choikiha7440-ops/bodycam-project/바디캠_프로젝트_학습서_2026-10-01.docx

바디캠 프로젝트 학습서 (2026-10-01)

ESP32-S3 보드로 만든 첫 진짜 바디캠: 카메라, SD카드, 서버 업로드, 그리고 디버깅 기록

저장소: https://github.com/choikiha7440-ops/bodycam-project

# 목차

1. 오늘의 결과 요약

2. 하드웨어 준비

3. 개발 환경 설정

4. 단계별 시험

5. 펌웨어 버전별 기록

6. 서버 버전별 기록

7. 문제 해결 기록

8. 서버 업데이트 절차

9. 오늘의 교훈

10. 아직 확인하지 못한 것과 다음 할 일

11. 복습 퀴즈

# 1. 오늘의 결과 요약

## 1.1 된 것

항목 | 확인 방법
XIAO ESP32S3 Sense 첫 업로드 | 점검 코드로 칩, PSRAM 8MB, SD 31.9GB, SD 쓰기와 읽기
OV3660 카메라 실시간 영상 | 카메라 예제로 브라우저에서 UXGA(1600x1200) 영상 확인
바디캠 펌웨어 실행 | 시리얼에 MQTT 연결됨, 시간 동기화 완료
라떼판다 BODYCAM 핫스팟 접속 | 와이파이 연결 10.42.0.82
대시보드에 진짜 바디캠 표시 | cam01 카드에 REC 시간과 라이브 영상
rec 명령으로 사전녹화 업로드 시작 | 시리얼 서버 업로드 시작, [ws] 연결됨
영상 항목 전송 | 보낸 항목 640개 (32초 x 초당 20개와 일치)

## 1.2 안 된 것 또는 확인하지 못한 것

항목 | 상태
녹화를 끝낸 뒤 서버의 확인 응답을 보드가 받는 것 | 되지 않음. [ws] 수신: 줄이 한 번도 나오지 않음
위 문제를 서버 1.3이 해결하는지 | 개발 PC에서만 시험함. 라떼판다에 아직 적용하지 못함
보드가 스스로 재시작된 원인 | 모름
MP4 안의 사전녹화 10초, 소리, 화면 방향 | 아직 재생해 보지 못함

솔직하게 적어 둔다. "된 것"은 눈으로 확인한 것만 넣었다.

# 2. 하드웨어 준비

## 2.1 구성품 (XIAO ESP32S3 Sense)

부품 | 설명
XIAO 본체 | USB-C, ESP32-S3 칩
확장 보드(Sense) | 카메라 커넥터, 마이크, microSD 슬롯(뒷면)
OV3660 카메라 | 주황색 필름 케이블에 이름이 적혀 있음
안테나 | 본체의 작은 금색 동그라미(U.FL)에 수직으로 눌러 끼움
방열판 | 본체 뒷면에 붙임
핀 헤더 | 납땜해서 버튼, LED를 연결할 때 사용 (아직 안 씀)

- microSD 슬롯은 본체가 아니라 확장 보드 뒷면에 있다.
- 카메라 렌즈의 초록색 보호 필름을 떼어야 선명하다.

## 2.2 SD카드 포맷

카드 | 규격 | 처리
SanDisk Ultra 32GB | microSDHC | 윈도우에서 FAT32로 바로 포맷 (볼륨 레이블에 CAM01처럼 이름)
삼성 EVO 64GB | microSDXC (exFAT) | ESP32 라이브러리는 FAT32가 확실함. 윈도우 기본 포맷에는 FAT32 선택지가 없어 별도 프로그램이 필요. 예비용

- 포맷 후 안전하게 제거하고 카드를 슬롯에 딸깍 소리가 나게 넣는다.
- 새 카드 포맷 직후 윈도우 저장소 화면에는 128KB 사용으로 나오는데, 윈도우가 만든 관리 정보라 정상이다.

# 3. 개발 환경 설정

## 3.1 아두이노 IDE (Tools 메뉴)

항목 | 설정 | 이유
Board | XIAO_ESP32S3 | XIAO_ESP32S3_PLUS는 다른 제품
PSRAM | OPI PSRAM | 카메라와 링버퍼가 이 메모리를 씀
USB CDC On Boot | Enabled | 시리얼 모니터 출력
Partition Scheme | Default with spiffs (3MB APP/1.5MB SPIFFS) | 다른 보드의 "Huge APP"은 이 보드에 없음
Port | 보드를 꽂았을 때 새로 생기는 COM 번호

- 시리얼 모니터 속도는 115200 (코딩어레이 우노의 9600과 다름).
- 포트가 안 보이면 BOOT 버튼을 누른 채 USB를 꽂는다.
- 라이브러리: PubSubClient (Nick O'Leary), WebSockets (Markus Sattler). 검색할 때 철자 주의 (PubSubClint는 오타).

## 3.2 업로드 때 나오는 메시지

메시지 | 뜻
Hash of data verified, Hard resetting | 업로드 성공
Multiple libraries were found for "SD.h" | 에러가 아니라 안내. ESP32 기본 라이브러리를 쓴다는 뜻
Sketch must be verified before starting a debug session | 디버그 버튼(벌레 모양)을 눌렀을 때 나오는 안내. 업로드는 화살표 버튼

# 4. 단계별 시험

한 번에 모든 것을 올리지 않고 작은 단계로 나눠 확인했다.

## 4.1 1단계: 보드 점검 코드

Serial.printf("칩: %s, 코어 %d개\n", ESP.getChipModel(), ESP.getChipCores());

Serial.printf("PSRAM: %d KB\n", ESP.getPsramSize() / 1024);

SD.begin(21); // Sense 보드의 SD 칩 선택 핀

결과: ESP32-S3, 코어 2개, PSRAM 8192KB, SD 30436MB, SD 쓰기와 읽기 성공.

## 4.2 2단계: 카메라 웹서버 예제

- File, Examples, ESP32, Camera, CameraWebServer를 연다.
- board_config.h에서 #define CAMERA_MODEL_XIAO_ESP32S3 한 줄만 켠다.
- 와이파이 이름과 비밀번호를 입력한다. PC와 같은 와이파이여야 브라우저로 볼 수 있다.
- 시리얼에 나온 주소를 브라우저에 입력하고 Start Stream.

## 4.3 3단계: 발열 확인

- 최고 화질(UXGA)로 몇 분 틀어 두고 만졌을 때 약간 따뜻한 정도였다.
- 바디캠 설정은 VGA(640x480), 품질 12라서 이보다 부담이 적다.
- 아직 30분 이상 장시간 시험은 하지 않았다.

## 4.4 4단계: 바디캠 펌웨어

- 버튼이 없어서 시리얼 모니터에 rec을 입력하면 버튼을 누른 것처럼 동작하게 만들었다.
- rec 한 번은 녹화 시작, 한 번 더는 종료.
- info는 현재 상태를 보여준다.

# 5. 펌웨어 버전별 기록

버전 | 변경 | 계기
0.2.0 | 처음 작성 | 보드 도착 전 설계
0.2.1 | rec 명령, 파티션 안내 정정 | 버튼을 납땜하기 전에 시험하기 위해
0.2.2 | RecState를 config.h로 이동 | 컴파일 에러 'RecState' does not name a type
0.2.3 | 업로드 포기 이유, 신호, 보낸 항목 수 출력 | 왜 업로드가 반복 실패하는지 알 수 없었음
0.2.4 | 확인 응답을 연결 상태보다 먼저 확인, 받은 글자 출력 | 코드에서 순서 허점을 발견
0.2.5 | 재시작 이유, SD 재시도, 힙 메모리 출력 | 스스로 재시작되고 SD를 못 찾음

## 5.1 컴파일 에러 `'RecState' does not name a type`

- 증상: getRec(), startLive(), publishEvent() 세 곳에서 같은 에러.
- 원인: 아두이노 IDE는 컴파일 전에 모든 함수의 선언(프로토타입)을 파일 맨 위에 자동으로 만들어 넣는다. RecState를 반환하거나 받는 함수의 선언이 구조체 정의보다 먼저 나와서 형식을 모른다.
- 해결: 직접 만든 구조체는 .ino가 아니라 헤더(config.h)에 정의한다.

## 5.2 `cam_hal: FB-OVF` 경고

- 카메라 프레임 버퍼가 넘친다는 경고. 영상이 정상적으로 찍히고 업로드되어서 무시해도 된다.
- 로그 수준을 낮춰서 숨기려 했지만 효과가 없었다. 카메라 드라이버가 직접 출력하기 때문이다.

# 6. 서버 버전별 기록

버전 | 변경 | 확인용 검색어
1.0 | 처음 버전 (9/29)
1.1 | 중복 연결로 생기던 에러 수정, 상태 정리 보장, 복구 장치 | refresh_uploading
1.2 | 영상이 없는 접속은 녹화 중으로 표시하지 않음 (유령 방지) | announced
1.3 | end 응답 뒤 보드가 닫을 때까지 최대 3초 대기 | wait_for(ws.receive()

## 6.1 서버 1.1: 대시보드가 빨간색에 갇히던 버그

File ".../app/main.py", line 208, in flush

FileNotFoundError: ... /raw/cam01_20261001-111515-a003/meta.json

단계 | 일어난 일
1 | 와이파이가 흔들려 보드가 같은 녹화에 다시 접속했다. 이전 연결도 서버에 남아 있었다.
2 | 한 연결이 end로 정상 종료되자 서버가 MP4를 만들고 임시 폴더를 지웠다.
3 | 남아 있던 다른 연결이 닫히면서 지워진 폴더에 쓰다가 에러가 났다.
4 | 에러가 "상태 정리" 코드보다 앞에서 났기 때문에 uploading과 recording이 true로 남았다.

교훈: 정리 코드는 finally에 넣고, 정리 도중 에러가 나도 다음 정리가 실행되게 감싼다.

## 6.2 서버 1.2: 유령 녹화

- 서버가 보드의 웹소켓 재접속을 새 녹화로 착각해 REC 0:04와 검은 화면을 띄웠다.
- 접속 순간이 아니라 첫 영상 프레임이 들어온 순간부터 녹화 중으로 표시하도록 바꿨다.

## 6.3 서버 1.3: 확인 응답을 놓치는 문제 (추정)

- 서버는 end를 받으면 {"ok": true}를 보내고 곧바로 연결을 닫는다.
- 보드의 웹소켓 라이브러리가 연결 종료를 먼저 알아채고 아직 읽지 않은 응답을 버릴 수 있다고 추정했다.
- 근거: 보드에 [ws] 수신: 줄이 한 번도 안 나왔고, 개발 PC의 파이썬 클라이언트는 응답을 받았다.
- 대응: 서버가 응답 뒤 보드가 먼저 닫을 때까지 최대 3초 기다린다.
- 추정이다. 실제 보드로 확인하지 못했다. 틀렸다면 서버 로그로 다시 원인을 찾는다.

# 7. 문제 해결 기록

증상 | 원인 | 해결
라이브러리 검색에 안 나옴 | 검색어 오타 (PubSubClint) | PubSubClient
컴파일 에러 RecState | 아두이노가 함수 선언을 자동으로 앞에 넣음 | 구조체를 config.h로 이동
대시보드에 바디캠이 안 뜸. 휴대폰도 BODYCAM에 접속 안 됨 | 라떼판다 핫스팟(USB 와이파이 동글)이 멈춤 | nmcli con down bodycam-ap 후 up. 이후 보드가 접속
녹화를 끝냈는데 대시보드가 계속 빨강 | 서버 버그 (6.1) | 서버 1.1
업로드가 계속 중단되고 재전송이 반복 | 확인 응답을 놓침 (추정) | 서버 1.3 (미확인)
서버를 업데이트했는데 효과가 없음 | 다운로드 폴더의 예전 zip을 보냄 | 아래 7.1
보드 재시작 뒤 SD카드 없음 또는 인식 실패 | 재시작 때 카드가 중간 상태에 갇힘 | USB를 뽑고 10초 뒤 다시 연결. 카드는 망가지지 않음
명령어를 윈도우에서 입력했더니 systemctl 용어가 인식되지 않음 | 라떼판다 명령을 PowerShell에 입력 | 프롬프트로 구분 (아래 7.2)

## 7.1 잘못된 파일을 보낸 일

- 단서: 압축을 풀 때 __pycache__/sd2mp4.cpython-312.pyc가 나왔다. 새 zip에는 없는 파일이었다.
- 확인 방법: 설치 후 grep -c "refresh_uploading" 결과가 0이었다.
- 예방: 풀기 전에 unzip -p 파일.zip bodycam-server/app/main.py | grep -c 검색어로 내용을 먼저 본다.
- 파일 이름이나 크기를 눈으로 읽는 것보다, 내용 안의 고유한 검색어가 정확하다.

## 7.2 어느 화면에서 입력하나

프롬프트 | 위치 | 쓰는 명령
PS C:\Users\CKH\Downloads> | 윈도우 PowerShell | scp, ssh, dir
panda@lattepanda:~$ | 라떼판다 | systemctl, unzip, grep, journalctl

# 8. 서버 업데이트 절차

순서 | 위치 | 명령
1 | 윈도우 | 예전 bodycam-server*.zip을 지우고 새로 다운로드
2 | 윈도우 | scp bodycam-server.zip panda@lattepanda:~
3 | 윈도우 | ssh panda@lattepanda
4 | 라떼판다 | 풀기 전에 새 파일인지 확인 (아래 명령, 결과 1이면 새 파일)
5 | 라떼판다 | cd ~ (띄어쓰기 필요)
6 | 라떼판다 | unzip -o bodycam-server.zip
7 | 라떼판다 | sudo systemctl restart bodycam
8 | 라떼판다 | systemctl is-active bodycam (active)
9 | 라떼판다 | grep -c "wait_for(ws.receive()" ~/bodycam-server/app/main.py (1)

4번 명령:

unzip -p ~/bodycam-server.zip bodycam-server/app/main.py | grep -c "wait_for(ws.receive()"

- 녹화본(recordings/)과 바디캠 이름(data/)은 덮어써지지 않는다.
- 이미 설치된 서버를 업데이트할 때는 install.sh가 필요 없다.
- 펌웨어는 라떼판다로 보내지 않는다. 윈도우 PC의 아두이노 IDE로 USB 업로드한다.

# 9. 오늘의 교훈

- 추측하기 전에 측정한다. "신호가 약해서 끊긴다"는 가설은 신호 세기를 출력해 보니 틀렸다(-52 dBm으로 아주 좋음). 진단 출력(0.2.3)이 방향을 바꿨다.
- 화면에 보이는 성공이 진짜 성공이 아닐 수 있다. 대시보드가 초록으로 돌아온 것은 MQTT 이벤트만으로도 가능해서, 영상이 올라갔다는 증거가 아니었다. 증거는 MP4 파일과 서버 로그다.
- 한 번에 하나만 바꾼다. 여러 개를 바꾸면 무엇이 효과였는지 알 수 없다.
- 파일은 내용으로 확인한다. 이름이나 날짜가 아니라 고유한 검색어로 확인한다.
- 정리 코드는 반드시 실행되게 한다. finally 안에서도 에러가 날 수 있으니 한 번 더 감싼다.
- 서버와 클라이언트는 한쪽이 먼저 닫으면 마지막 메시지를 잃을 수 있다. 마지막 메시지를 받았음을 확인한 쪽이 닫는 편이 안전하다.
- 보드 설정은 보드마다 다르다. 다른 보드의 안내를 그대로 따르지 않고 실제 메뉴에서 확인한다.

# 10. 아직 확인하지 못한 것과 다음 할 일

## 10.1 아직 모르는 것

- 서버 1.3이 확인 응답 문제를 해결하는지
- 보드가 스스로 재시작된 원인 (패닉인지, 전원 문제인지)
- MP4 안에 사전녹화 10초, 소리, 올바른 화면 방향이 들어 있는지
- 업로드를 여러 번 반복해도 메모리(힙)가 줄지 않는지

## 10.2 다음에 할 일

- 라떼판다에 서버 1.3 적용 (7.1의 방법으로 파일 내용부터 확인)
- 펌웨어 0.2.5 업로드, 시리얼의 [재시작 이유]와 SD 줄 확인
- rec 후 시리얼에 [ws] 수신: {"ok": true ...}와 업로드 완료가 나오는지 확인
- 녹화 기록의 MP4를 재생해서 사전녹화, 소리, 방향 확인
- 같은 시험을 3번 반복해서 결과 표로 기록
- 안테나를 다시 끼우고 신호 세기 비교
- 나머지 보드 2대에 같은 펌웨어, id cam02, id cam03
- 버튼, RGB LED, 배터리 분압 회로 납땜
- MediaTek 와이파이 동글 교체 검토

# 11. 복습 퀴즈

- 1. XIAO ESP32S3 Sense의 microSD 슬롯은 어디에 있는가?
- 2. 이 보드에서 PSRAM 설정은 무엇으로 해야 하는가?
- 3. 시리얼 모니터 속도는 우노와 어떻게 다른가?
- 4. 아두이노 IDE에서 직접 만든 구조체를 .ino에 두면 왜 에러가 나는가?
- 5. 대시보드가 초록색으로 돌아왔다는 것이 업로드 성공의 증거가 못 되는 이유는?
- 6. 풀기 전에 zip 안의 파일이 최신인지 확인하는 방법은?
- 7. 보드 로그의 보낸 항목 640개는 왜 이 녹화에서 "영상을 다 보냈다"는 근거가 되는가?
- 8. 서버가 end 응답 직후 연결을 닫으면 어떤 일이 생길 수 있다고 추정했는가?
- 9. SD카드가 재시작 뒤에 안 읽혔을 때 가장 먼저 할 일은?

## 정답

- 1. 확장 보드(Sense) 뒷면
- 2. OPI PSRAM
- 3. 115200 (우노는 9600)
- 4. 아두이노가 컴파일 전에 함수 선언을 파일 맨 위에 자동으로 넣는데, 그 선언이 구조체 정의보다 앞에 나오기 때문. 구조체를 헤더에 두면 해결된다.
- 5. 대시보드의 빨강과 초록은 MQTT의 rec_start와 rec_stop 신호로도 바뀌기 때문. 영상이 올라갔는지는 MP4와 서버 로그로 확인해야 한다.
- 6. unzip -p 파일.zip 경로 | grep -c 고유한검색어
- 7. 10초 사전녹화 + 약 22초 녹화 = 32초이고, 초당 영상 10개 + 음성 10개로 32 x 20 = 640이기 때문
- 8. 보드의 웹소켓 라이브러리가 응답을 읽기 전에 연결 종료를 알아채서 응답을 놓칠 수 있다 (추정)
- 9. USB를 뽑고 10초 뒤 다시 연결해서 카드까지 전원을 완전히 끊었다 켠다
