choikiha7440-ops/bodycam-project/bodycam-project/bodycam project 10월 2일 최종버전/CHANGELOG.md

# 버전별 기록 (CHANGELOG)

"확인" 표시의 뜻
- **보드 확인**: 실제 XIAO ESP32S3 Sense 보드와 라떼판다에서 동작을 확인함
- **PC 시험**: 개발 PC에서 가짜 바디캠(파이썬)으로 시험함. 실제 보드로는 아직 확인 안 됨
- **문법 검사만**: 컴파일과 동작은 아직 확인 안 됨

---

## 펌웨어 (bodycam_firmware)

| 버전 | 날짜 | 변경 | 상태 |
|---|---|---|---|
| 0.2.0 | 2026-09-28 | 처음 작성. 링버퍼 사전녹화, SD 블랙박스, 서버 업로드, LED, 배터리 | 문법 검사만. 아두이노 IDE에서는 `RecState` 컴파일 에러가 남 |
| 0.2.1 | 2026-10-01 | 시리얼 `rec` 명령 추가 (버튼 없이 녹화 시험). 파티션 안내를 기본값(Default with spiffs)으로 정정 | `RecState` 컴파일 에러가 그대로 있음. 직접 고쳐서 보드 확인 |
| 0.2.2 | 2026-10-01 | `RecState` 구조체를 `config.h`로 이동 (아두이노가 함수 선언을 자동으로 앞에 넣기 때문) | 컴파일 통과. 같은 구조로 보드 확인 |
| 0.2.3 | 2026-10-01 | 업로드 포기 이유, 보낸 항목 수, 신호 세기, 웹소켓 연결 기록 출력. `info`에 rssi | 보드 확인. `FB-OVF` 경고 숨기기는 **효과 없음** |
| 0.2.4 | 2026-10-01 | 확인 응답(ack)을 연결 상태보다 먼저 확인. ack를 받으면 바로 연결 닫기. 받은 글자 출력 | 보드 확인(업로드, 동작). 서버 1.3과 함께 ack 수신은 미확인 (cam01이 아직 0.2.4) |
| 0.2.5 | 2026-10-01 | 재시작 이유 출력, SD 초기화 재시도(10MHz→4MHz), 힙 메모리 출력 | **보드 확인 (2026-10-02)**: cam01(COM7), cam02(COM8), cam03(COM9)에 업로드. 재시작 이유 출력, SD 10MHz 연결, 서버 1.3과 함께 ack 수신·업로드 완료 확인 |

### 펌웨어 보드 설정 (XIAO_ESP32S3)
- Board: XIAO_ESP32S3 / PSRAM: **OPI PSRAM** / USB CDC On Boot: **Enabled**
- Partition Scheme: **Default with spiffs (3MB APP/1.5MB SPIFFS)** (기본값, 다른 보드의 "Huge APP"과 다름)
- 라이브러리: PubSubClient (Nick O'Leary), WebSockets (Markus Sattler)

---

## 서버 (bodycam-server)

서버 코드 안에는 버전 번호가 없어서, 아래 "확인용 검색어"로 어떤 버전인지 알 수 있다.

| 버전 | 날짜 | 변경 | 확인용 검색어 | 상태 |
|---|---|---|---|---|
| 1.0 | 2026-09-29 | MQTT 수신, 웹소켓 업로드, 링 버퍼, MP4 변환, 대시보드 | (없음) | 시뮬레이터로 시험 |
| 1.1 | 2026-10-01 | 같은 녹화에 연결이 둘 붙었을 때 임시 폴더가 지워진 뒤 쓰다가 생기던 `FileNotFoundError` 수정. 연결 수 계산. 연결이 닫힐 때 상태 정리를 반드시 실행. 바디캠이 "대기 중"이라고 보고하면 녹화 표시 해제. 감시 루프가 "연결 없는데 업로드 중" 상태를 복구 | `refresh_uploading` | PC 시험. 라떼판다에 설치됨(검색어 3개 확인) |
| 1.2 | 2026-10-01 | 접속만 하고 영상이 없는 연결(유령)은 녹화 중으로 표시하지 않음. 첫 프레임이 들어온 순간부터 표시 | `announced` | PC 시험. 라떼판다 설치 여부는 확인 안 됨 |
| 1.3 | 2026-10-01 | `end` 확인 응답을 보낸 뒤 바디캠이 먼저 연결을 닫을 때까지 최대 3초 기다림 (응답을 읽기 전에 연결이 닫혀 응답을 놓치는 문제 대응) | `wait_for(ws.receive()` | **보드 확인 (2026-10-02)**: 라떼판다에 적용. 펌웨어 0.2.5에서 `[ws] 수신: {"ok": true ...}` 확인 |
| 1.4 | 2026-10-02 | 바디캠이 시간 동기화 전에 녹화하면 1970-01-01로 저장되던 문제 수정. 시각이 2020년 이전이면 서버 시계로 날짜를 다시 매김 (녹화 도중 동기화된 경우도 처리). MQTT `rec_start`의 시각도 같은 방식으로 보정 | `TIME_VALID_MS` | PC 시험 (동기화 전, 정상, 도중 동기화, 중복 프레임, 이벤트). **보드 확인 (2026-10-02)**: 라떼판다 적용(검색어 3). cam03을 부팅 직후 `rec` → 세션 `boot4197-0cb6`, 오늘 날짜 09:52:36으로 저장. 녹화 도중 동기화되는 경우는 보드로 미확인 |

### 서버 업데이트 절차 요약
1. 윈도우에서 `scp 파일 panda@lattepanda:~/bodycam-server.zip`
2. 라떼판다에서 **풀기 전에** 새 파일인지 확인: `unzip -p ~/bodycam-server.zip bodycam-server/app/main.py | grep -c "TIME_VALID_MS"` → 3 (1.4 기준)
3. `cd ~ && unzip -o bodycam-server.zip && sudo systemctl restart bodycam`
4. 설치 후 확인: `grep -c "TIME_VALID_MS" ~/bodycam-server/app/main.py` → 3 (1.4 기준)

---

## 해결된 것 (2026-10-02)

- **ack 문제**: 서버 1.3 + 펌웨어 0.2.5에서 `[ws] 수신:`과 `업로드 완료` 확인 (cam01, cam02, cam03 모두). cam01은 10:03:00 녹화, 세션 10:03:10보다 10초 앞에서 시작. 1.3과 0.2.5 중 어느 쪽이 결정적이었는지는 구분 안 됨.
- **시간 동기화 전 녹화 날짜**: 1.3까지는 1970-01-01로 저장됨. 서버 1.4로 해결 (cam03 09:52:36 녹화로 확인). 1.4 이전에 만든 1970-01-01 녹화는 그대로 남아 있음.
- **MP4 확인**: cam02 09:33:48 녹화. 세션 시작 09:33:58보다 10초 앞에서 시작(사전녹화 확인), 25초, 9fps, 소리 들림, 화면 방향 정상.

## 아직 해결되지 않은 것 (2026-10-02 기준)

1. **보드가 스스로 재시작된 원인**: `rst:0x3 (RTC_SW_SYS_RST)`가 한 번 관찰됨. 원인 미확인. 펌웨어 0.2.5의 `[재시작 이유]` 출력으로 확인 예정.
2. 재시작 직후 SD카드를 못 찾던 현상: USB 전원을 완전히 껐다 켜면 복구됨. 0.2.5의 재시도로 완화 예정(미확인).
3. 재시작 이유 `기타 (코드 11)`: 펌웨어 업로드 직후 cam01에서 나옴. ESP-IDF 기준 11은 USB에 의한 재시작(`ESP_RST_USB`)으로 업로드 후에는 정상으로 **추정**. 0.2.5의 이유 목록에 없어 "기타"로 표시됨. 다음 펌웨어에서 이름 추가 예정.
4. 라떼판다 USB 와이파이 동글(RTL8821CU)이 핫스팟을 오래 켜 두면 멈추는 일이 있음 (껐다 켜면 복구). MediaTek 동글 교체 예정.
