choikiha7440-ops/bodycam-project/bodycam-project/coding-array/mini_bodycam_v7/hangul.h

#pragma once
// 한글 글자 비트맵 (XBM 형식). Noto Sans CJK KR로 미리 그려서 넣은 그림입니다.
// 아두이노 우노는 메모리가 작아서 한글 글꼴 전체를 넣을 수 없어 필요한 글자만 그림으로 넣었어요.

const unsigned char K16_CHAL[] PROGMEM = { // 촬
  0x20, 0x08, 0x20, 0x08, 0xfe, 0x09, 0x30, 0x08, 0x58, 0x38, 0x8e, 0x09, 0x20, 0x08, 0xe0, 0x0b, 0xfe, 0x0b, 0x00, 0x00, 0xf8, 0x0f, 0x00, 0x08, 0xf8, 0x0f, 0x08, 0x00, 0x08, 0x00, 0xf8, 0x1f };
const unsigned char K16_YEONG[] PROGMEM = { // 영
  0x00, 0x00, 0x78, 0x18, 0x4c, 0x18, 0x86, 0x1f, 0x82, 0x18, 0x82, 0x18, 0x86, 0x1f, 0x4c, 0x18, 0x38, 0x18, 0x00, 0x00, 0xe0, 0x07, 0x30, 0x0c, 0x18, 0x18, 0x18, 0x18, 0x30, 0x0c, 0xe0, 0x07 };
const unsigned char K16_JUNG[] PROGMEM = { // 중
  0xfc, 0x1f, 0xc0, 0x00, 0xc0, 0x01, 0x60, 0x03, 0x3c, 0x1e, 0x0c, 0x18, 0x00, 0x00, 0xfe, 0x3f, 0x80, 0x00, 0xf0, 0x07, 0x18, 0x0c, 0x0c, 0x08, 0x0c, 0x08, 0x18, 0x0c, 0xf0, 0x07, 0x00, 0x00 };
const unsigned char K16_DAE[] PROGMEM = { // 대
  0x00, 0x10, 0x00, 0x13, 0x7e, 0x13, 0x06, 0x13, 0x06, 0x13, 0x06, 0x13, 0x06, 0x13, 0x06, 0x1f, 0x06, 0x13, 0x06, 0x13, 0x06, 0x13, 0x7e, 0x13, 0x00, 0x13, 0x00, 0x13, 0x00, 0x13, 0x00, 0x10 };
const unsigned char K16_GI[] PROGMEM = { // 기
  0x00, 0x00, 0x00, 0x18, 0xfc, 0x18, 0x80, 0x18, 0x80, 0x18, 0x80, 0x18, 0xc0, 0x18, 0x40, 0x18, 0x60, 0x18, 0x30, 0x18, 0x18, 0x18, 0x0e, 0x18, 0x02, 0x18, 0x00, 0x18, 0x00, 0x18, 0x00, 0x18 };
const unsigned char K16_CHUNG[] PROGMEM = { // 충
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
const unsigned char K16_SEOK[] PROGMEM = { // 석
  0x00, 0x00, 0x20, 0x18, 0x30, 0x18, 0x30, 0x18, 0x30, 0x1f, 0x70, 0x18, 0x48, 0x18, 0x8c, 0x19, 0x02, 0x18, 0x00, 0x00, 0xf8, 0x1f, 0x00, 0x18, 0x00, 0x18, 0x00, 0x18, 0x00, 0x18, 0x00, 0x18 };
